TerryGeng/teach-me-a-pid/README.md

# teach-me-a-pid
Simplified schematic of a PID controller
