TerryGeng/teach-me-a-pid/kicad/clamp_test/clamp_test.kicad_pcb

## KiCad design kicad/clamp_test/clamp_test.kicad_pcb (2023-11-17)

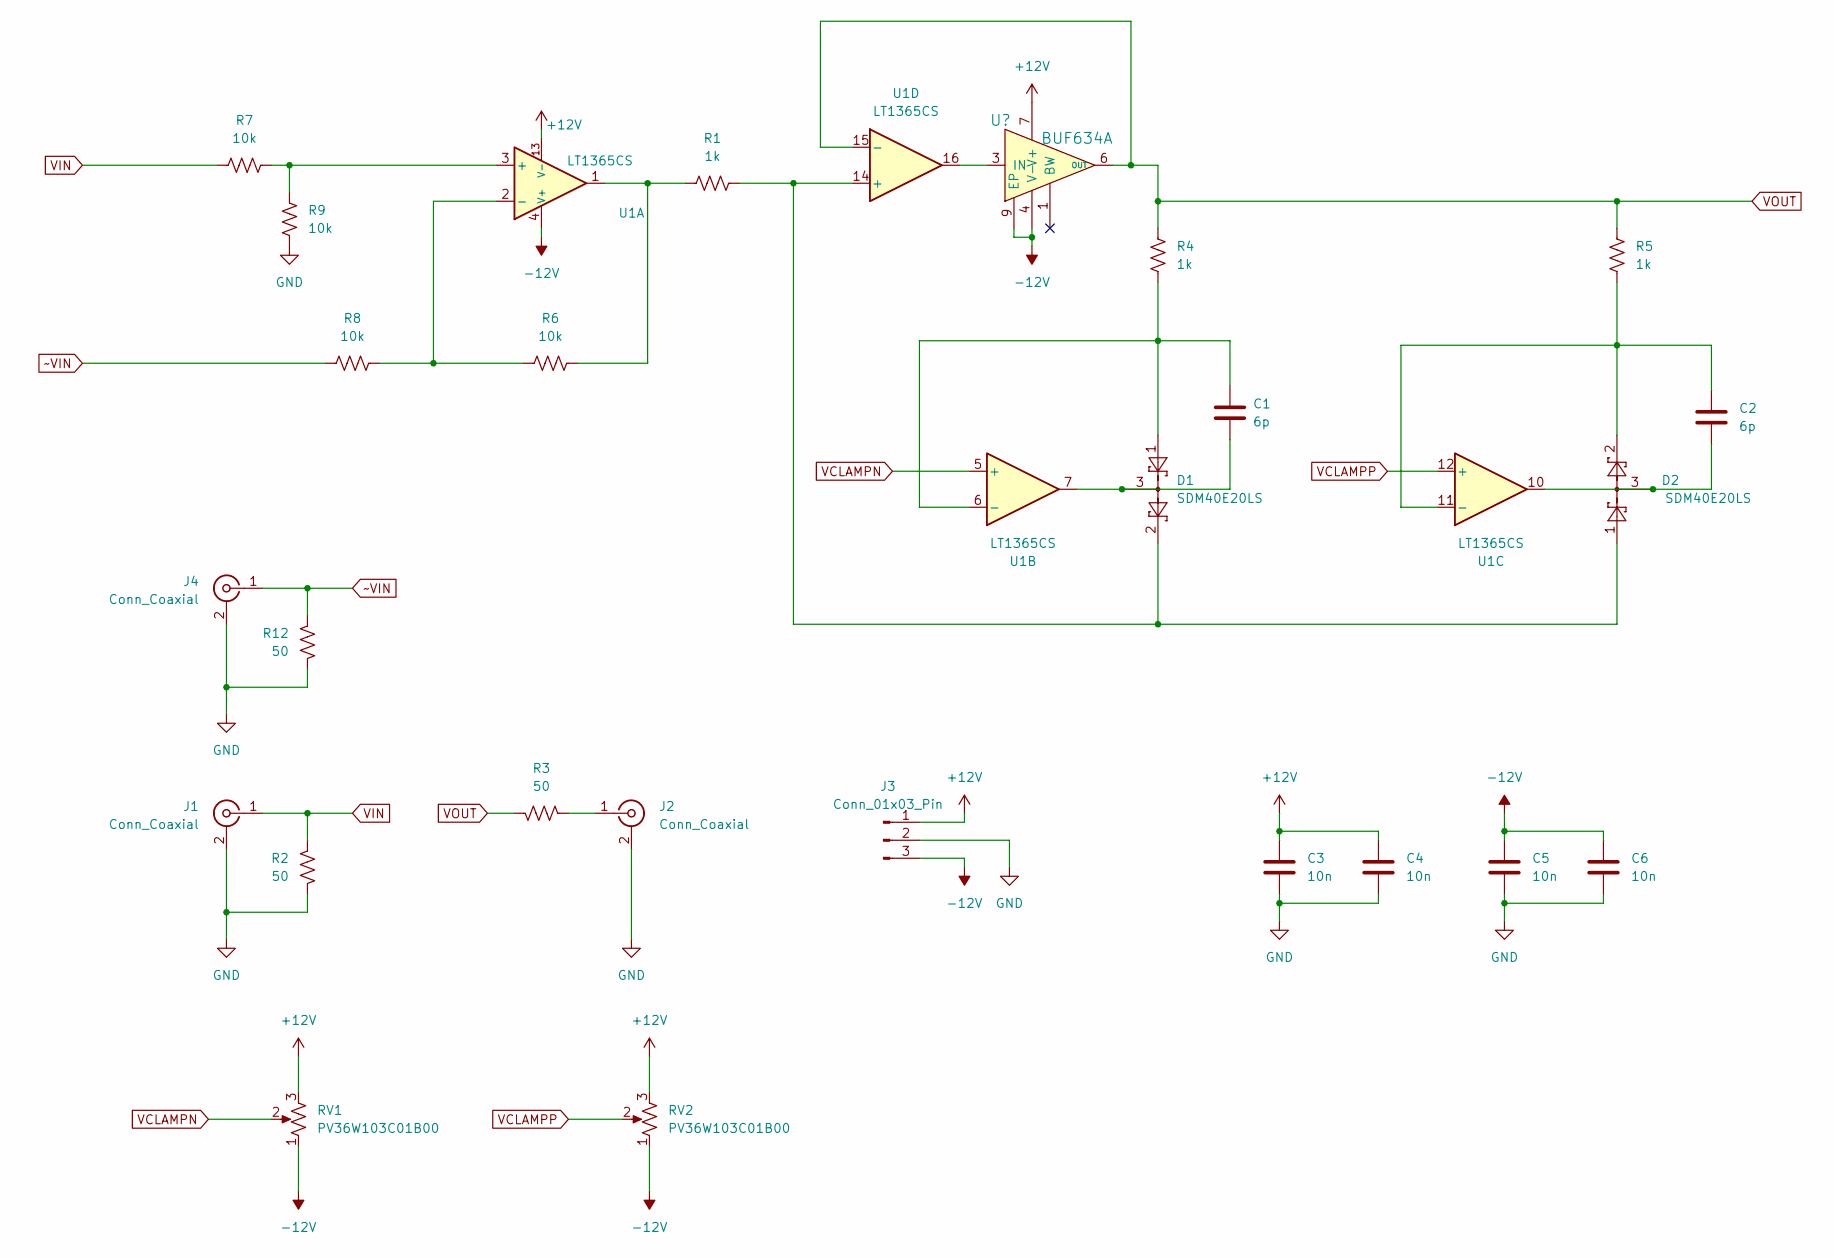
[picture p1: schematic clamp_test.kicad_sch]

Parts:
C1, C2: 6p; C_0603_1608Metric
C3, C4, C5, C6: 10n; C_0603_1608Metric
D1, D2: SDM40E20LS; SOT-23
J1, J2, J4: Conn_Coaxial; SMA_Amphenol_132291_Vertical
J3: Conn_01x03_Pin; PinHeader_1x03_P2.54mm_Vertical
R1, R4, R5: 1k; R_0603_1608Metric
R2, R3, R12: 50; R_0603_1608Metric
R6, R7, R8, R9: 10k; R_0603_1608Metric
RV1, RV2: PV36W103C01B00; Potentiometer_Bourns_3296W_Vertical
U1: LT1365CS; SOIC-16_3.9x9.9mm_P1.27mm
U2: BUF634A; TI_SO-PowerPAD-8_ThermalVias; PARTNO BUF634AIDDAR; DIGIKEY 296-BUF634AIDDARCT-ND

Connections:
+12V: C3.1, C4.1, J3.1, RV1.3, RV2.3, U1.13 (V-), U2.7 (V+)
-12V: C5.1, C6.1, J3.3, RV1.1, RV2.1, U1.4 (V+), U2.4 (V-), U2.9 (EP)
GND: C3.2, C4.2, C5.2, C6.2, J1.2 (Ext), J2.2 (Ext), J3.2, J4.2 (Ext), R2.2, R9.2, R12.2
unnamed: C1.2, D1.3, U1.7
unnamed: C2.2, D2.3, U1.10
unnamed: J2.1 (In), R3.2
unnamed: R1.1, R6.1, U1.1
unnamed: R7.1, R9.1, U1.3 (+)
unnamed: R6.2, R8.1, U1.2 (-)
unnamed: C1.1, D1.1, R4.1, U1.6 (-)
unnamed: C2.1, D2.2, R5.1, U1.11 (-)
unnamed: D1.2, D2.1, R1.2, U1.14 (+)
unnamed: U1.16, U2.3 (IN)
VCLAMPN: RV1.2, U1.5 (+)
VCLAMPP: RV2.2, U1.12 (+)
VIN: J1.1 (In), R2.1, R7.2
VOUT: R3.1, R4.2, R5.2, U1.15 (-), U2.6 (OUT)
~VIN: J4.1 (In), R8.2, R12.1

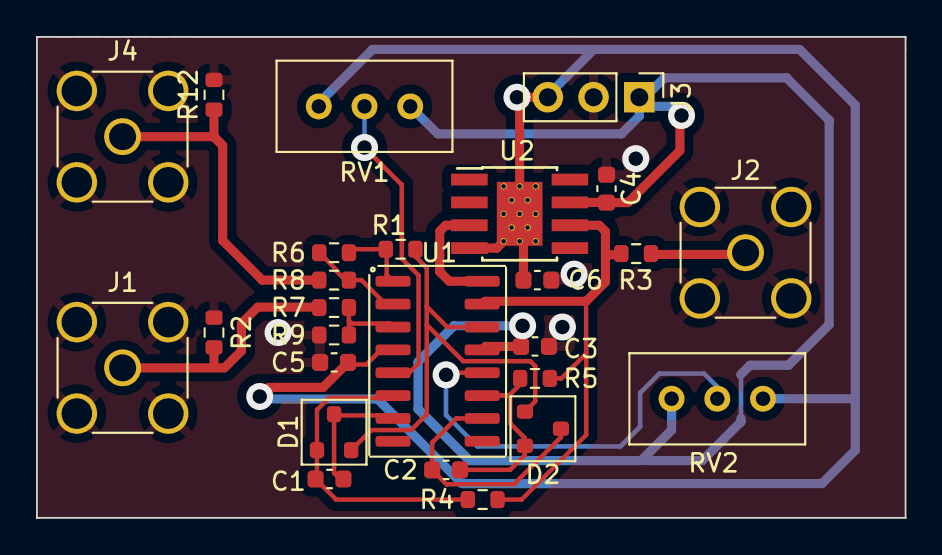
[picture p2: board clamp_test.kicad_pcb from above]

Board: 2 copper layers, 48.3 x 26.7 mm, 26 parts (0 on the bottom side), 18 nets.
