TerryGeng/teach-me-a-pid/kicad/integrator_test/integrator_test/integrator_test.kicad_pcb

## KiCad design kicad/integrator_test/integrator_test/integrator_test.kicad_pcb (2023-10-10)

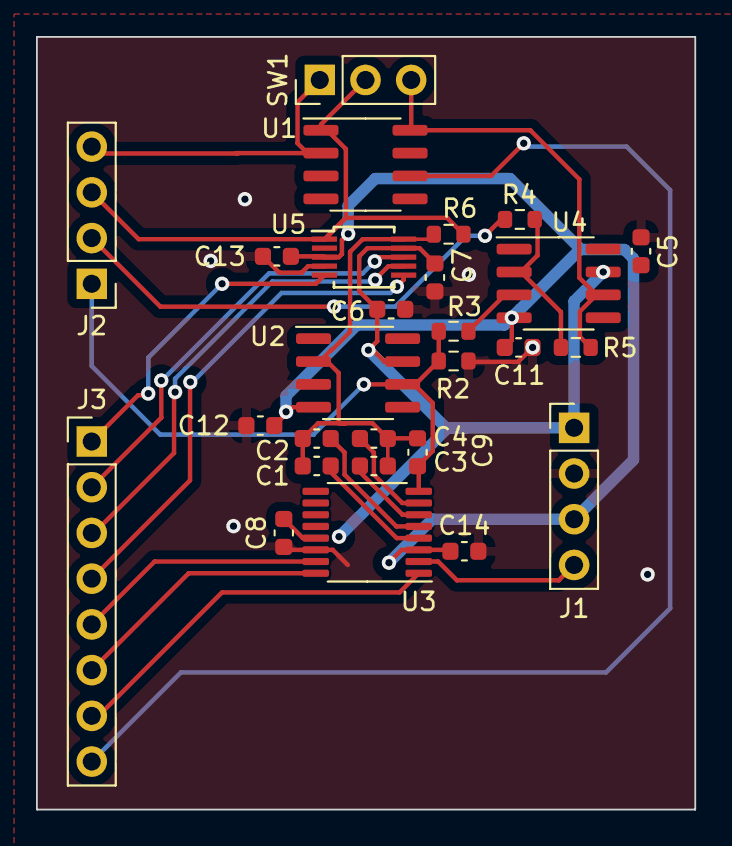
[picture p3: board integrator_test.kicad_pcb from above]

Board: 2 copper layers, 36.6 x 42.9 mm, 27 parts (0 on the bottom side), 24 nets.

Parts:
C1: 1nF; C_0603_1608Metric
C2: 10nF; C_0603_1608Metric
C3, C5, C6, C7, C8, C11, C12, C13, C14: 100nF; C_0603_1608Metric
C4: 1uF; C_0603_1608Metric
C9: DNP; C_0603_1608Metric
J1, J2: Conn_01x04_Pin; PinHeader_1x04_P2.54mm_Vertical
J3: Conn_01x08_Pin; PinHeader_1x08_P2.54mm_Vertical
R2, R4: 1k; R_0603_1608Metric
R3, R5: 4.8k; R_0603_1608Metric
R6: DNP; R_0603_1608Metric
SW1: SW_SPDT; PinHeader_1x03_P2.54mm_Vertical
U1: DG419DY-T1-E3; SOIC-8_3.9x4.9mm_P1.27mm
U2, U4: OPA189; SOIC-8_3.9x4.9mm_P1.27mm
U3: DG408DQ-T1-E3; TSSOP-16_4.4x5mm_P0.65mm
U5: AD5290; MSOP-10_3x3mm_P0.5mm

Connections:
+3V3: J1.4, U3.2 (EN)
+12V: C5.1, C6.1, C7.1, C8.1, J1.1, U2.7 (V+), U3.13 (VDD), U4.7 (V+), U5.9 (Vdd+)
-12V: C11.1, C12.1, C13.1, C14.1, J1.3, U2.4 (V-), U3.3 (VSS), U4.4 (V-), U5.3 (Vss-)
GND: C5.2, C6.2, C7.2, C8.2, C11.2, C12.2, C13.2, C14.2, J1.2, R2.1, U2.3 (+), U3.14 (GND), U5.4 (GND)
INT_CAP_SEL_A0: J3.7, U3.1 (A0)
INT_CAP_SEL_A1: J3.6, U3.16 (A1)
INT_CAP_SEL_A2: J3.5, U3.15 (A2)
INT_R+: J2.3, R6.1, SW1.2 (B), U1.1, U5.1 (RH)
INT_R-: C1.1, C2.1, C3.1, C4.1, C9.1, R6.2, U2.2 (-), U5.10 (RW)
I_IN: J2.4, SW1.1 (A), U1.2
I_OUT: C9.2, J2.1, R2.2, R3.1, U2.6, U3.8 (D)
I_OVERRIDE: J2.2, R4.1
I_OVERRIDE_EN: J3.8, U1.6
unnamed: R5.2, SW1.3 (C), U1.8, U4.6
unnamed: C1.2, U3.4 (S1)
unnamed: C2.2, U3.5 (S2)
unnamed: C3.2, U3.6 (S3)
unnamed: C4.2, U3.7 (S4)
unnamed: R3.2, U4.3 (+)
unnamed: R4.2, R5.1, U4.2 (-)
R_CLK: J3.4, U5.6 (CLK)
R_CS: J3.1, U5.5 (~CS)
R_SDI: J3.3, U5.7 (SDI)
R_SDO: J3.2, U5.8 (SDO)
