TerryGeng/teach-me-a-pid/(commit log)

2023-06-27 Schematic made.
    TO DO:
    1) Figure out the values for all components to provide a suitable
    2) design the power supply and filtering section.
    3) Find suitable potentiometers and switches: I like the idea of sliders! (they occupy space however!)
    4) Find a suitable footprint for the capacitor socket: maybe a zif?
    [basic_pid.kicad_pcb, basic_pid.kicad_sch, supply.kicad_sch]
2023-07-01 Schematic almost finalized:
    Ended up using switches to select pre-set capacitors rather than ZIFs
    1) design the power supply and filtering section.
    2) Layout work (consider adding capacitors for stabilization...)
    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
    [basic_pid.kicad_pcb, basic_pid.kicad_sch, supply.kicad_sch]
2023-07-06 last partial schematic using OPA189 everywhere
    [supply.kicad_sch]
2023-07-07 Schematic finalized and layout work begun
    [basic_pid.kicad_pcb, basic_pid.kicad_sch, supply.kicad_sch]
2023-07-11 Layout almost completed
    This is an almost completed snapshot of the layout. Here what to do:
    1) Make sure that when flipped the back has sliders on the bottom: this will require
    reversing the direction of increasing gain with consequent shortening of certain
    signal traces
    2) Fix the position of connectors, sliders and switches to "reasonable locations"
    3) Make a verbose silkscreen (expecially on bottom) showing all functions.
    [basic_pid.kicad_pcb, basic_pid.kicad_sch, supply.kicad_sch]
2023-07-13 Board is functionally operational but requires more reviews:
    TO DO list
    1) Substitute input op-amps with an INA849: that should give higher bandwidth
    2) Make sure that when flipped the back has sliders on the bottom: this will require
    3) Fix the position of connectors, sliders and switches to "reasonable locations"
    4) Make a verbose silkscreen (expecially on bottom) showing all functions.
    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
    [basic_pid.kicad_pcb, basic_pid.kicad_sch]
2023-07-24 version sent to Advanced Circuits and OSHStencils
    [basic_pid-B_Cu.gbr, basic_pid-B_Mask.gbr, basic_pid-B_Silkscreen.gbr, basic_pid-Edge_Cuts.gbr, basic_pid-F_Cu.gbr, basic_pid-F_Mask.gbr, basic_pid-F_Paste.gbr, basic_pid-F_Silkscreen.gbr]
2023-09-28 smart pid schematics
    [D_block.kicad_sch, Digital_control.kicad_sch, Digital_interface.kicad_sch, I_block.kicad_sch, P_block.kicad_sch, basic_pid.kicad_pcb, basic_pid.kicad_sch, supply.kicad_sch]
2023-09-29 Added inverter and modified ext. setpoint disable
    [D_block.kicad_sch, Digital_interface.kicad_sch, I_block.kicad_sch, P_block.kicad_sch, basic_pid.kicad_sch, supply.kicad_sch]
2023-10-02 added integrator test board
    [integrator_test.kicad_pcb, integrator_test.kicad_sch]
2023-10-09 integrator test board v2
    [integrator_test.kicad_pcb, integrator_test.kicad_sch]
2023-10-10 Optimzied some traces for the integrator test board
    [integrator_test.kicad_pcb, integrator_test.kicad_sch]
2023-11-14 Clamp test board: first version
    [clamp_test.kicad_pcb, clamp_test.kicad_sch]
2023-11-15 Clamp test board: removed unused vias
    [clamp_test.kicad_pcb]
2023-11-16 Changed buffer position
    [clamp_test.kicad_pcb, clamp_test.kicad_sch]
2023-11-17 adjusted layout
    [clamp_test.kicad_pcb, clamp_test.kicad_sch]
